K4rim-0/Autonomous-Modular-Greenhouse/hardware/DXF files/README.md

Here are the dxf files I used for laser cutting the wood to build the containment.
I will mention part name and the quantity. 
format: partName_quantity.dxf
