K4rim-0/Autonomous-Modular-Greenhouse/hardware/DXF files/mainTopFace_1.dxf

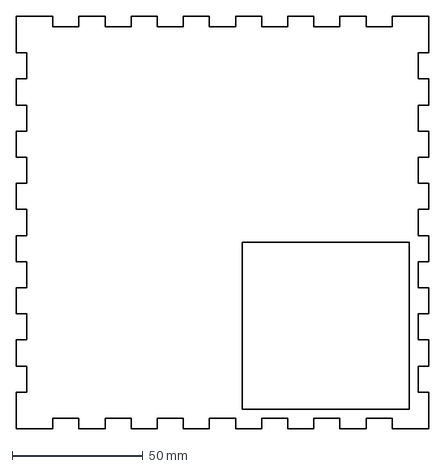
[picture p19: CAD file, 2026-10-19]
hardware/DXF files/mainTopFace_1.dxf
158.0 x 158.0 mm
