K4rim-0/Autonomous-Modular-Greenhouse/hardware/DXF files/mainFrontFace_1.dxf

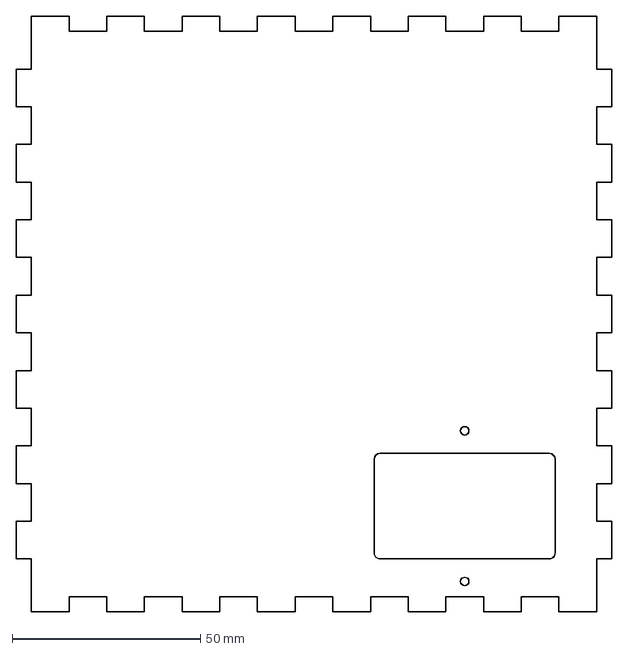
[picture p20: CAD file, 2026-10-19]
hardware/DXF files/mainFrontFace_1.dxf
158.0 x 158.0 mm
