K4rim-0/Autonomous-Modular-Greenhouse/hardware/DXF files/mainLeftFace_1.dxf

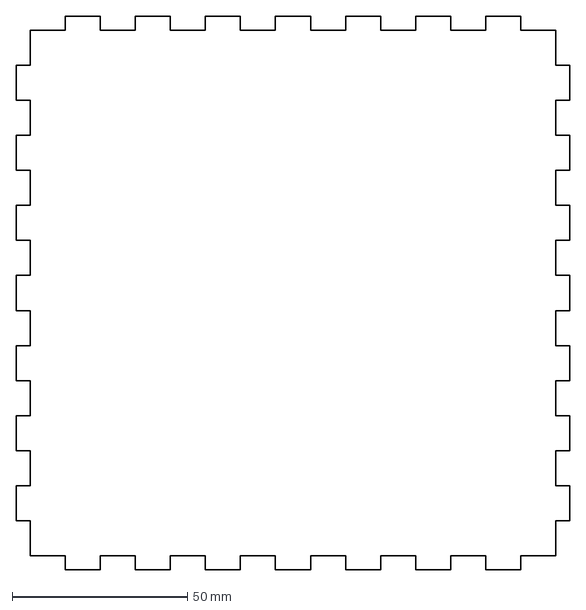
[picture p21: CAD file, 2026-10-19]
hardware/DXF files/mainLeftFace_1.dxf
158.0 x 158.0 mm
