K4rim-0/Autonomous-Modular-Greenhouse/hardware/3D/rodGuides.stl

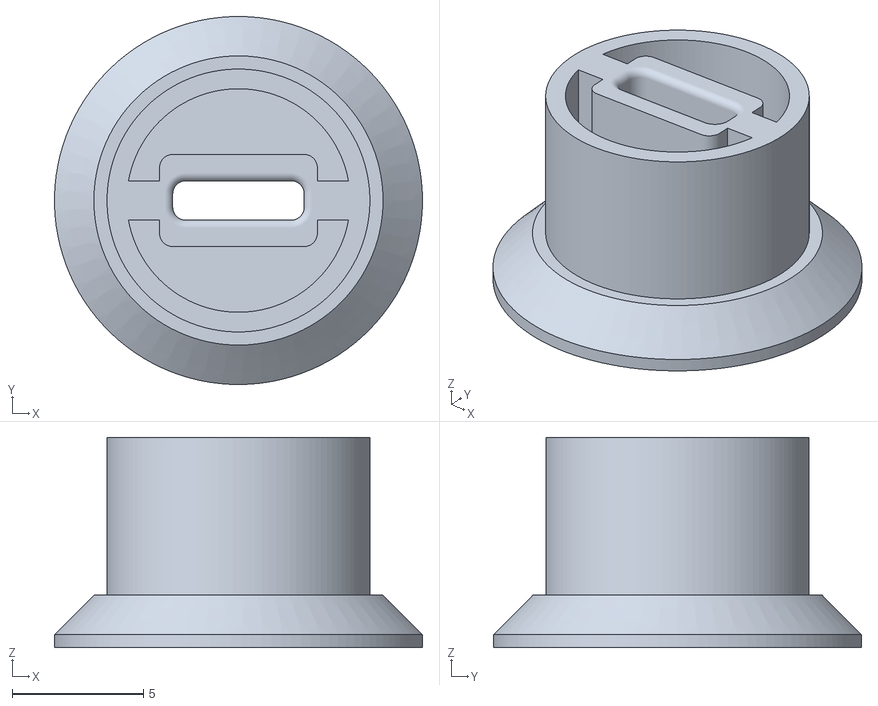
[picture p22: CAD file, 2026-10-17]
hardware/3D/rodGuides.stl
14.0 x 14.0 x 8.00
