K4rim-0/Autonomous-Modular-Greenhouse/hardware/DXF files/airUnitTopBottomFace_2.dxf

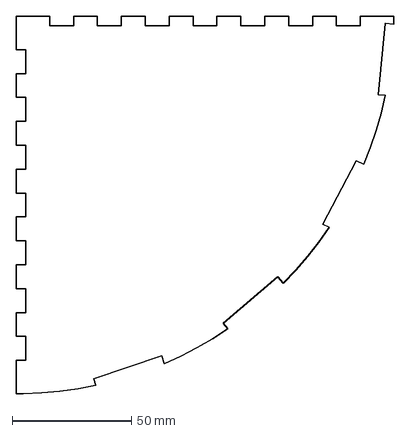
[picture p23: CAD file, 2026-10-19]
hardware/DXF files/airUnitTopBottomFace_2.dxf
158.0 x 158.0 mm
