K4rim-0/Autonomous-Modular-Greenhouse/hardware/3D/sg90holder.stl

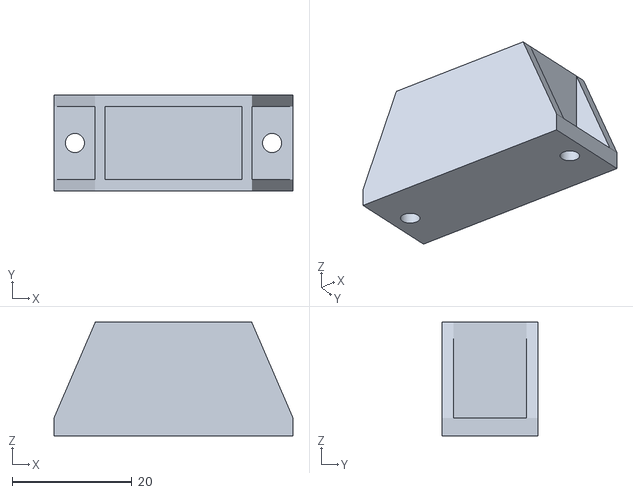
[picture p24: CAD file, 2026-10-17]
hardware/3D/sg90holder.stl
40.0 x 16.0 x 19.0
