K4rim-0/Autonomous-Modular-Greenhouse/hardware/3D/XT60portsM.stl

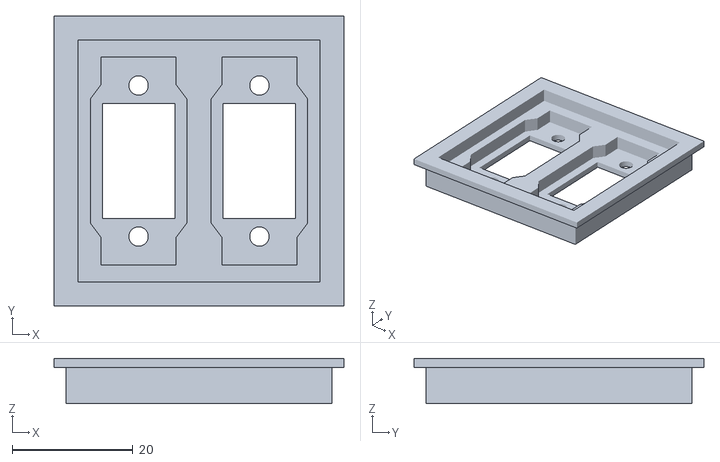
[picture p25: CAD file, 2026-10-17]
hardware/3D/XT60portsM.stl
48.0 x 48.0 x 7.50
