K4rim-0/Autonomous-Modular-Greenhouse/hardware/3D/gratePegCentral.stl

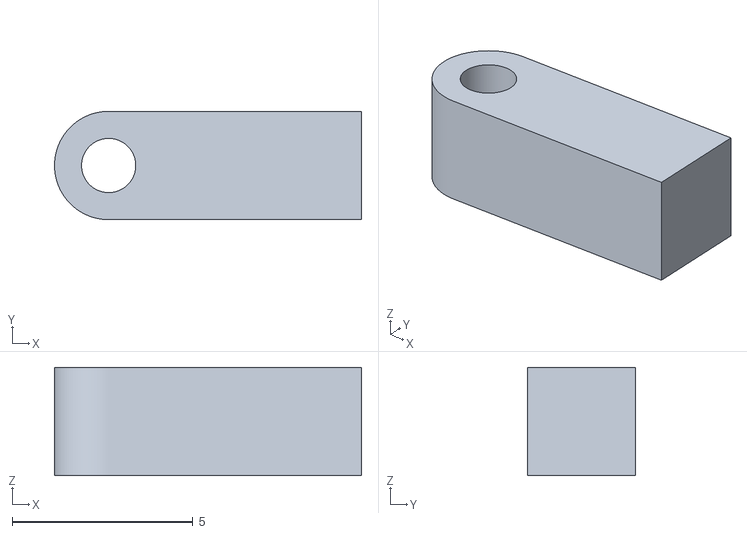
[picture p26: CAD file, 2026-10-17]
hardware/3D/gratePegCentral.stl
8.50 x 3.00 x 3.00
