K4rim-0/Autonomous-Modular-Greenhouse/hardware/DXF files/airUnitMovingGrate_4.dxf

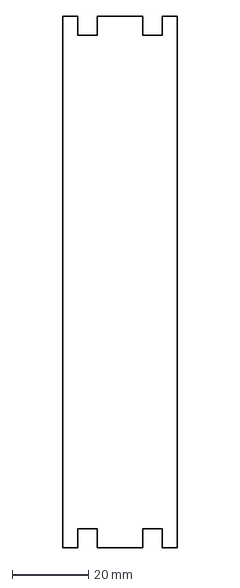
[picture p27: CAD file, 2026-10-19]
hardware/DXF files/airUnitMovingGrate_4.dxf
30.0 x 139.0 mm
