K4rim-0/Autonomous-Modular-Greenhouse/hardware/DXF files/airUnitLeftFace_1.dxf

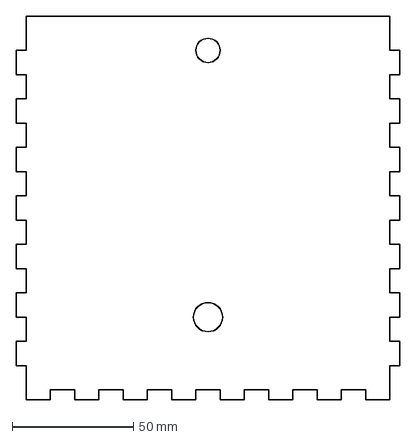
[picture p29: CAD file, 2026-10-19]
hardware/DXF files/airUnitLeftFace_1.dxf
158.0 x 158.0 mm
