K4rim-0/Autonomous-Modular-Greenhouse/hardware/3D/XT60portsMCovers.stl

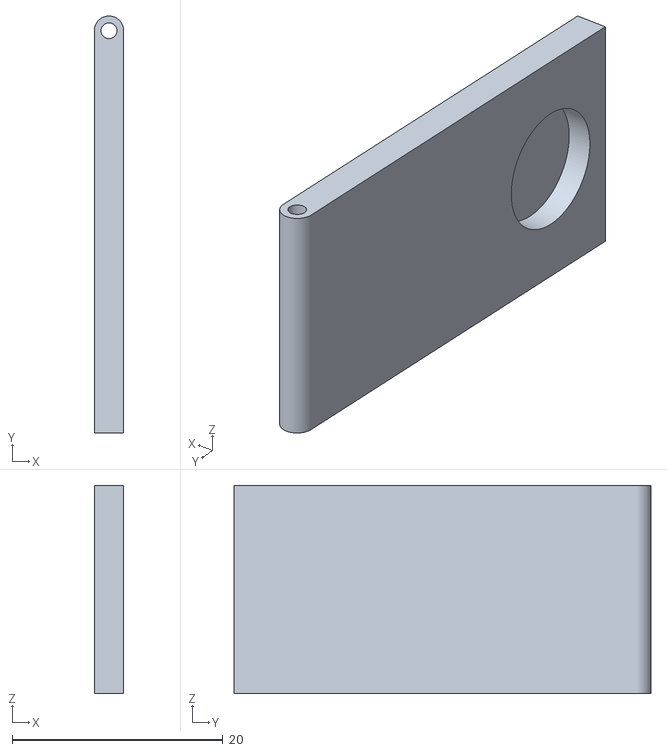
[picture p30: CAD file, 2026-10-17]
hardware/3D/XT60portsMCovers.stl
2.80 x 39.6 x 19.8
