K4rim-0/Autonomous-Modular-Greenhouse/hardware/3D/rail.stl

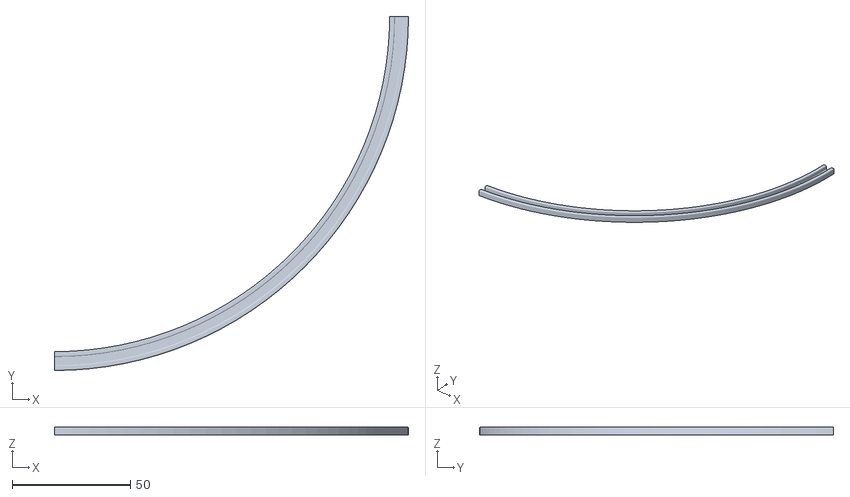
[picture p31: CAD file, 2026-10-17]
hardware/3D/rail.stl
150.0 x 150.0 x 3.50
