K4rim-0/Autonomous-Modular-Greenhouse/hardware/DXF files/airUnitBackFace.dxf

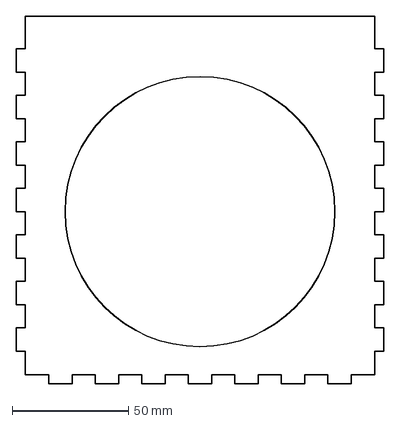
[picture p32: CAD file, 2026-10-19]
hardware/DXF files/airUnitBackFace.dxf
158.0 x 158.0 mm
