K4rim-0/Autonomous-Modular-Greenhouse/hardware/3D/dhtPorts.stl

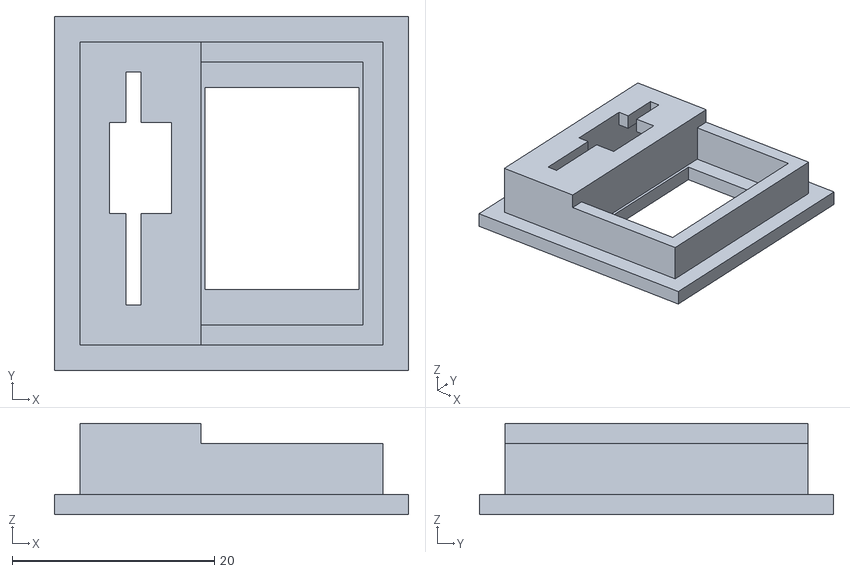
[picture p33: CAD file, 2026-10-17]
hardware/3D/dhtPorts.stl
35.0 x 35.0 x 9.00
