K4rim-0/Autonomous-Modular-Greenhouse/hardware/3D/fanOutlet.stl

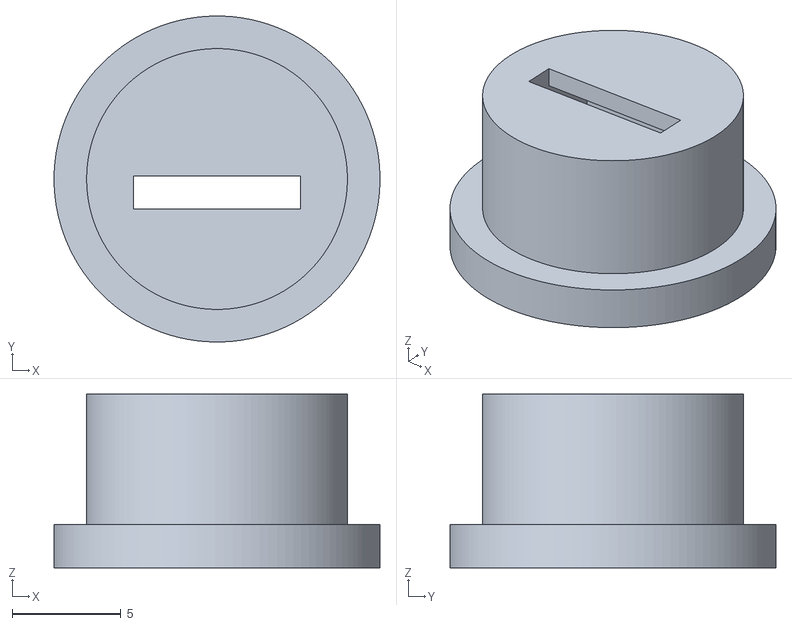
[picture p34: CAD file, 2026-10-17]
hardware/3D/fanOutlet.stl
15.0 x 15.0 x 8.00
