K4rim-0/Autonomous-Modular-Greenhouse/hardware/DXF files/airUnitStationaryGrates_4.dxf

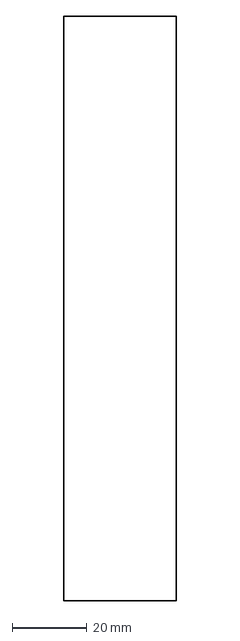
[picture p35: CAD file, 2026-10-19]
hardware/DXF files/airUnitStationaryGrates_4.dxf
30.0 x 156.0 mm
