K4rim-0/Autonomous-Modular-Greenhouse/hardware/3D/UIcover.stl

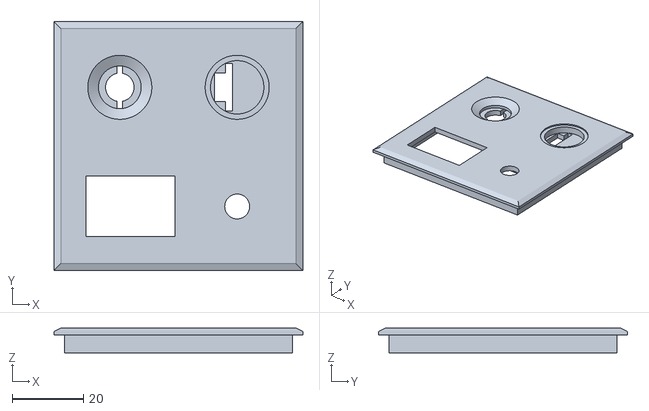
[picture p36: CAD file, 2026-10-17]
hardware/3D/UIcover.stl
70.0 x 70.0 x 7.00
