K4rim-0/Autonomous-Modular-Greenhouse/hardware/3D/WHU_v2_stl.stl

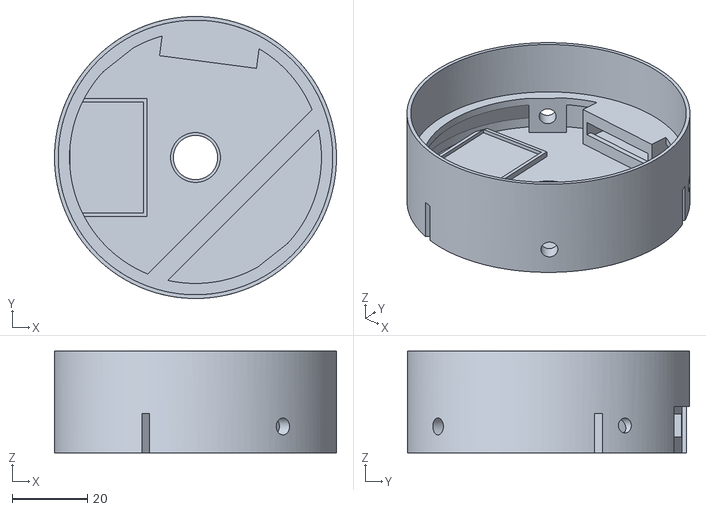
[picture p37: CAD file, 2026-10-17]
hardware/3D/WHU_v2_stl.stl
75.0 x 75.0 x 27.0
