K4rim-0/Autonomous-Modular-Greenhouse/(notices)

Notices in the files:
hardware/DXF files/mainBottomFace_1.dxf:
CC0
